Miron-Andrei/Portable-Electronic-Device-for-Measuring-Electrical-Components-and-Values/Illuminance test.jpg

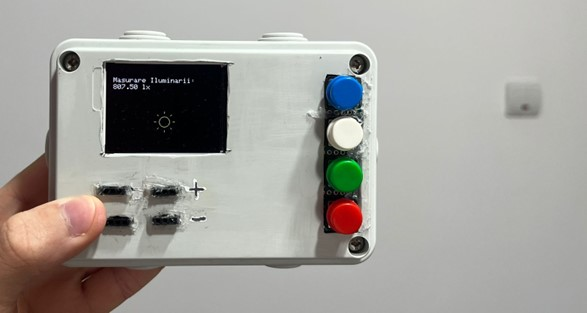
Illuminance test.jpg
