Miron-Andrei/Portable-Electronic-Device-for-Measuring-Electrical-Components-and-Values/Resistor test 2.7 KOhm.jpg

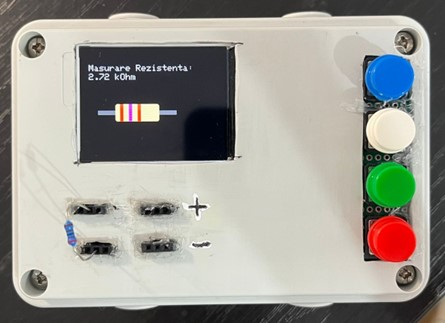
Resistor test 2.7 KOhm.jpg
