Miron-Andrei/Portable-Electronic-Device-for-Measuring-Electrical-Components-and-Values/Device.jpg

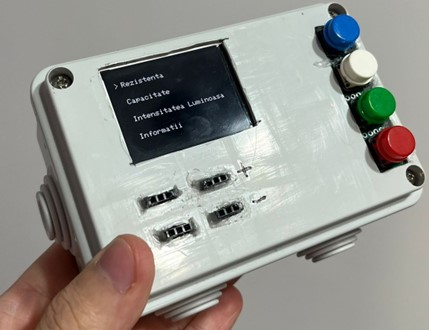
Device.jpg
