Miron-Andrei/Portable-Electronic-Device-for-Measuring-Electrical-Components-and-Values/Inside the Device.jpg

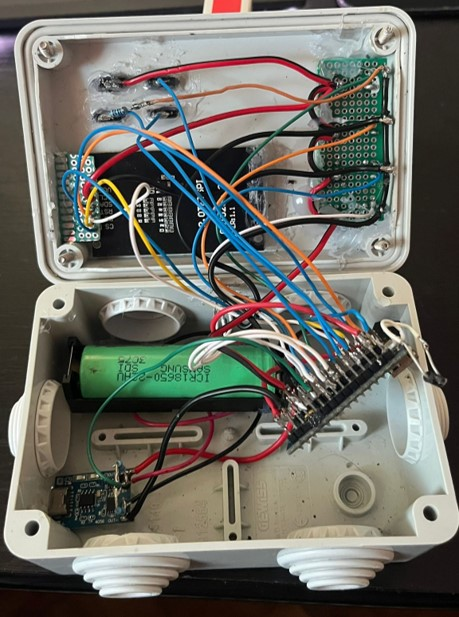
Inside the Device.jpg
