Miron-Andrei/Portable-Electronic-Device-for-Measuring-Electrical-Components-and-Values/KiCad Scheme.png

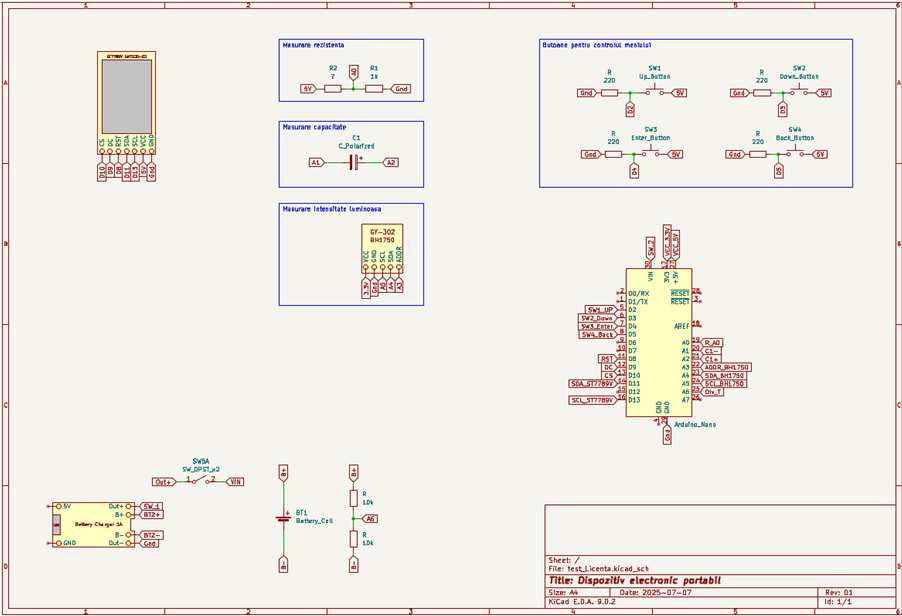
KiCad Scheme.png
