Miron-Andrei/Portable-Electronic-Device-for-Measuring-Electrical-Components-and-Values/Wokwi Scheme.png

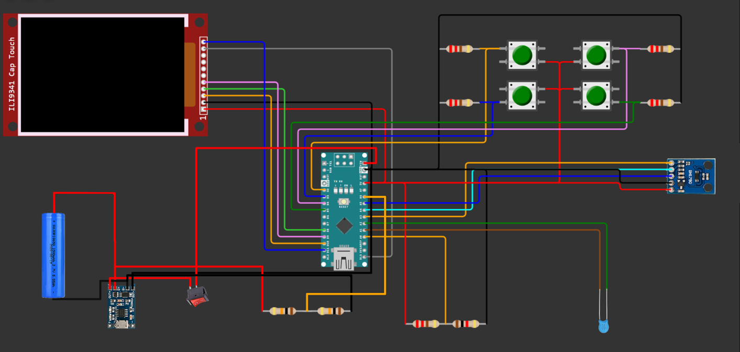
Wokwi Scheme.png
