Miron-Andrei/Portable-Electronic-Device-for-Measuring-Electrical-Components-and-Values/Capacitor test 100 nF.jpg

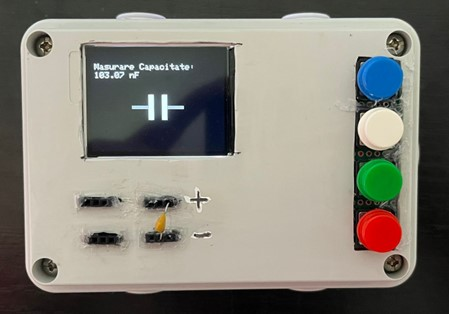
Capacitor test 100 nF.jpg
